stefanluethi/robby/doc/bench/results-2026-10-26.md

# Trace link benchmark, 2026-10-26

Hardware campaign of [the plan](../plan/protobuf-tracing.md) §7: the sonde firmware
(baseline) and the protobuf firmware (nanopb on the STM32, robby outpost on the ESP32),
measured on robby with the tools in `tools/bench`.

## Summary

- **The protobuf link carries all IMU samples with room to spare.** All 806 samples/s
  arrive with no gaps, against 403/s (decimated) with sonde. It uses **8 % of the UART**
  instead of 69 %, because each sample costs **~7 B on the UART instead of 159 B**
  (10 B/sample when the other traces are counted in).
- **sonde can't carry all samples.** With decimation off it fills the 1 Mbaud link
  (83 kB/s), delivers only 521 of 806 samples/s with 176 gaps (up to 141 ms) in 60 s,
  and the distance, battery and task traces stop entirely.
- **The ESP32 is now the bottleneck, not the UART.** The whole chain carries
  **~5.8k samples/s cleanly (~440 kB/s on WiFi)** and saturates at **~7k samples/s
  (~530 kB/s)**: the ESP32 CPU is at 96 % (idle 3.6 %) and its queue starts dropping.
  At that point the UART is only at 60 %; it would saturate at ~11–12k samples/s
  (85 % load, then the STM32 drops records).
- **The plain WiFi limit of the ESP32-C6** (outpost generating the data itself, no UART):
  clean up to **8k samples/s / 607 kB/s**, first drops at 9k / 683 kB/s, peak ~700 kB/s
  (≈ 5.6 Mbit/s), at RSSI −61 to −64 dBm.
- **Headroom:** the robot's stream today (806 samples/s) uses ~1/7 of the chain's clean
  capacity. Compared with sonde's maximum (521 samples/s), the chain carries **~11× more
  samples**.

| | sonde (H0-a) | sonde, all samples (H0-b) | protobuf (H1-a) |
|---|---:|---:|---:|
| IMU samples/s delivered | 402.6 (decimated by 2) | 521.3 of 806 | **806.7** |
| IMU gaps | 1 in 120 s | 176 in 60 s (22 s total, max 141 ms) | **0 in 120 s** |
| IMU interval jitter (stddev) | 0.11 ms | 9.4 ms | **0.05 ms** |
| UART load | 69.0 kB/s (69 %) | 83.0 kB/s (full) | **8.2 kB/s (8 %)** |
| UART bytes per IMU sample | 159 | 159 | **~7 (IMU only), 10.1 (incl. all traces)** |
| WiFi (WebSocket) | 69.0 kB/s | 83.0 kB/s | 61.2 kB/s (68 B/sample) |
| ToF / battery / tasks | 6.2 / 1 / 1 Hz | stopped | 6.2 / 1 / 1 Hz |
| STM32 `data_publisher` CPU | 8.4 % | – | 8.9 % |
| ESP32 CPU idle | – | – | 82 % |
| errors / drops | 0 | 0 counted, 35 % of samples lost | 0 |

## Where the limit is (H1-b, 1 Mbaud, ramp with `bench/load`)

Synthetic IMU-like samples on top of the normal stream (806 samples/s), 20 s per step.

| requested /s | delivered /s | ratio | WiFi kB/s | UART load | ESP32 idle | ESP32 queue drops | ESP32 UART errors | STM32 drops | max WS send |
|---:|---:|---:|---:|---:|---:|---:|---:|---:|---:|
| 1,000 | 1,000 | 100 % | 137 | 15 % | 68 % | 0 | 0 | 0 | 0.7 ms |
| 2,000 | 1,998 | 100 % | 213 | 24 % | 54 % | 0 | 0 | 0 | 0.4 ms |
| 3,000 | 3,000 | 100 % | 289 | 30 % | 39 % | 0 | 1 | 0 | 4 ms |
| 5,000 | 4,987 | 99.7 % | 440 | 44 % | 15 % | 0 | 1 (4 seq gaps) | 0 | 23 ms |
| 7,000 | 6,249 | 89 % | 535 | 60 % | **4 %** | **155** | 6 | 0 | 24 ms |
| 9,000 | 6,128 | 68 % | 519 | 74 % | 10 % | 618 | 3 | 0 | 56 ms |
| 11,000 | 5,805 | 53 % | 497 | 85 % | 3 % | 935 | 1 | **115** | 25 ms |
| 13,000 | 5,723 | 44 % | 491 | 87 % | 6 % | 1,008 | 1 | 454 | 26 ms |

How to read it (plan §5): the ESP32 runs out of CPU at ~7k samples/s (6.2k synthetic +
0.8k IMU) and drops frames from its UART→WebSocket queue, while the UART still has 40 %
left. Above that, the WiFi throughput even goes down a little (535 → 491 kB/s): the CPU
spends more time on frames it then drops. The UART itself tops out at ~85 % load
(11k requested), where the STM32 starts dropping records.

### WiFi alone (H1-w, `bench-wifi`, no UART)

| requested /s | delivered /s | ratio | WiFi kB/s | dropped by the generator | max WS send |
|---:|---:|---:|---:|---:|---:|
| 1,000 | 998 | 100 % | 77 | 0 | 0.1 ms |
| 2,000 | 2,004 | 100 % | 153 | 0 | 0.1 ms |
| 5,000 | 4,996 | 100 % | 381 | 0 | 0.7 ms |
| 6,000 | 6,008 | 100 % | 458 | 0 | 3 ms |
| 7,000 | 7,002 | 100 % | 533 | 0 | 3 ms |
| 8,000 | 7,977 | 99.7 % | 607 | 0 | 12 ms |
| 9,000 | 8,981 | 99.8 % | 683 | 136 | 20 ms |
| 10,000 | 9,168 | 92 % | 698 | 8,270 | 28 ms |

The plain WiFi/TCP path of the ESP32-C6 (esp-radio + embassy-net, 16 KiB TCP buffer,
4 KiB WebSocket frames) peaks at ~700 kB/s. The chain stops ~25 % earlier (530 kB/s),
because the ESP32 also receives, checks and decodes the UART. Note: in `bench-wifi` mode
the generator itself uses the CPU, so its `cpu_idle` isn't comparable with the chain's.

## Problems found

1. **`bench/load` dropped 87 % of its batches at 1000 samples/s** (the first ramp
   stopped at its first step). The backlog was measured from a batch's first sample,
   not from its last. Fixed during the campaign in A4's `51ad8f9`, with a host test.
2. **WiFi stalls of 200–350 ms overflow the ESP32 queue even at moderate load.** In a
   3k-samples/s step the WebSocket send stalled several times for up to 350 ms, and
   59 frames were dropped from the 32-frame queue (the next run of the same step was
   clean). At normal load (H1-a) the longest send was 0.6 ms and nothing was dropped.
3. **Sporadic ESP32 UART RX errors under load.** 1–6 CRC errors / RX errors per 20 s
   step from 3k samples/s on, none at normal load. This fits RX FIFO overruns while the
   CPU is busy with WiFi (risk noted in plan §8).
4. **An action answer can get lost under overload.** At 13k samples/s the final
   `bench/load {rate: 0}` got "no answer from the STM32": the `ActionResult` travels in
   the same uplink queue that was dropping frames. The next request worked.

## Not measured

- **H1-c, baud sweep (2–4 Mbaud):** skipped. At 1 Mbaud the UART still has 40 % left
  when the ESP32 saturates, so a faster UART can't raise the limit.
- **H1-w close to the AP:** needs the robot moved; all runs were at its normal place
  (RSSI −58 to −64 dBm).
- Each ramp step ran once; WiFi stalls (problem 2) make single steps near the limit
  vary from run to run.

## Next steps (suggestions)

- To raise the limit, make the ESP32 cheaper per sample: profile the translation /
  CBOR encoding on the target, send fewer, larger WebSocket frames, and try turning off
  WiFi power saving (untested).
- Robustness: a larger or byte-based uplink queue against WiFi stalls (problem 2), UART
  RX by DMA (UHCI) on the ESP32 (problem 3), and send `ActionResult`s ahead of the
  traces (problem 4).

## Setup

| | |
|---|---|
| baseline firmware | tag `bench/baseline-sonde` (892f3f3), both chips; H0-b with `ACCELERATION_DECIMATION {1U}` (local, not committed) |
| protobuf firmware | STM32 `claude/nanopb-core-1fc850` @ b37cb7c (H1-a) and 51ad8f9 (ramps); ESP32 `claude/protobuf-outpost-0ee3ad` @ 7eca843 (`--features bench-wifi` for H1-w) |
| link | USART2 ↔ UART1, 1 Mbaud 8N1 |
| WiFi | bridge at 192.168.1.70, RSSI −58 to −64 dBm, robot at its normal place |
| tools | `tools/bench` from `claude/bench-tooling-8ac75a` @ f4b4202; recordings in that worktree's `tools/bench/runs/` (not committed) |

The robot was left running the protobuf firmware (STM32 51ad8f9, ESP32 7eca843 without
`bench-wifi`).

## Appendix: generated tables

### Runs

| run | kind | label | started | duration s | notes |
| --- | --- | --- | --- | --- | --- |
| h0-a | capture | H0-a baseline sonde | 2026-10-26T21:28:47+01:00 | 120.0 | firmware=bench/baseline-sonde, baud=1000000, decimation=2 |
| h0-b | capture | H0-b sonde all samples | 2026-10-26T21:31:53+01:00 | 60.0 | firmware=bench/baseline-sonde+decimation1, baud=1000000, decimation=1 |
| h1-a | capture | H1-a protobuf | 2026-10-26T21:47:39+01:00 | 120.0 | firmware=nanopb-core@b37cb7c+outpost@7eca843, baud=1000000 |
| h1-b-full | ramp | H1-b full curve 1M | 2026-10-26T21:56:24+01:00 |  | baud=1000000, rssi=-62 |
| h1-w-near | ramp | H1-w WiFi only (robby position) | 2026-10-26T21:51:13+01:00 |  | firmware=outpost@7eca843+bench-wifi, rssi=-61, position=robby-normal |
| h1-w-fine | ramp | H1-w WiFi only, fine | 2026-10-26T21:52:14+01:00 |  | firmware=outpost@7eca843+bench-wifi, rssi=-61 |

### Comparison

Baseline: **h0-a**, ratios relative to it. `imu/acc` styles: h0-a per-axis, h0-b per-axis, h1-a record. UART bytes from: h0-a: WS, h0-b: WS, h1-a: counter (WS = WebSocket payload, the baseline bridge forwards UART frames 1:1).

| metric | h0-a | h0-b | h1-a |
| --- | ---: | ---: | ---: |
| WS payload kB/s | 69.0 | 83.0 (1.20×) | 61.2 (0.89×) |
| WS frames/s | 73 | 83 (1.14×) | 22 (0.29×) |
| messages/s | 1,241 | 1,565 (1.26×) | 861 (0.69×) |
| `imu/acc` samples/s | 402.6 | 521.3 (1.29×) | 806.7 (2.00×) |
| `imu/acc` WS bytes/sample | 159.0 | 159.0 (1.00×) | 68.0 (0.43×) |
| `imu/acc` interval mean ms | 2.481 | 1.920 (0.77×) | 1.240 (0.50×) |
| `imu/acc` interval stddev ms | 0.110 | 9.440 (86.04×) | 0.047 (0.43×) |
| `imu/acc` interval max ms | 15.510 | 141.152 (9.10×) | 1.380 (0.09×) |
| `imu/acc` gaps | 1 | 176 (176.00×) | 0 (0.00×) |
| UART kB/s | 69.0 | 83.0 (1.20×) | 8.2 (0.12×) |
| UART bytes/`imu/acc` sample | 171.4 | 159.2 (0.93×) | 10.1 (0.06×) |
| drops (counters) | 0 | 0 | 0 |
| decode errors | 0 | 0 | 0 |

### h0-a: traces

| path | msgs/s | B/msg | bytes | mean ms | stddev ms | max ms | gaps |
| --- | ---: | ---: | ---: | ---: | ---: | ---: | ---: |
| `imu/acc/x` | 402.6 | 53.0 | 30.9% | 2.481 | 0.110 | 15.510 | 1 |
| `imu/acc/z` | 402.6 | 53.0 | 30.9% | 2.481 | 0.117 | 18.110 | 1 |
| `imu/acc/y` | 402.6 | 53.0 | 30.9% | 2.481 | 0.117 | 18.110 | 1 |
| `tof/distance` | 6.2 | 492.4 | 4.4% | 161.949 | 48.472 | 338.000 | 0 |
| `tasks/data_publisher` | 0.9 | 114.0 | 0.2% | 1,056.491 | 46.869 | 1,122.000 | 0 |
| `tasks/acquisition` | 0.9 | 111.0 | 0.2% | 1,056.393 | 53.184 | 1,122.000 | 0 |
| `tasks/heartbeat` | 0.9 | 108.0 | 0.1% | 1,056.393 | 53.159 | 1,122.000 | 0 |
| `tasks/Tmr Svc` | 0.9 | 107.0 | 0.1% | 1,056.393 | 52.380 | 1,121.000 | 0 |
| `tasks/command` | 0.9 | 107.0 | 0.1% | 1,056.393 | 52.959 | 1,122.000 | 0 |
| `tasks/IDLE` | 0.9 | 103.0 | 0.1% | 1,056.491 | 46.860 | 1,122.000 | 0 |
| `tasks/imu` | 0.9 | 103.0 | 0.1% | 1,056.393 | 52.409 | 1,121.000 | 0 |
| `battery/voltage` | 1.0 | 59.0 | 0.1% | 1,007.771 | 43.472 | 1,119.000 | 0 |

4 more paths.

### h0-b: traces

| path | msgs/s | B/msg | bytes | mean ms | stddev ms | max ms | gaps |
| --- | ---: | ---: | ---: | ---: | ---: | ---: | ---: |
| `imu/acc/z` | 521.4 | 53.0 | 33.3% | 1.919 | 9.440 | 141.152 | 176 |
| `imu/acc/x` | 521.3 | 53.0 | 33.3% | 1.920 | 9.440 | 141.152 | 176 |
| `imu/acc/y` | 521.3 | 53.0 | 33.3% | 1.920 | 9.440 | 141.152 | 176 |

### h1-a: traces

| path | msgs/s | B/msg | bytes | mean ms | stddev ms | max ms | gaps |
| --- | ---: | ---: | ---: | ---: | ---: | ---: | ---: |
| `imu/acc` | 806.7 | 68.0 | 89.6% | 1.240 | 0.047 | 1.380 | 0 |
| `tof/distance` | 6.2 | 491.7 | 5.0% | 161.134 | 6.207 | 180.000 | 0 |
| `tasks/data_publisher` | 1.0 | 114.0 | 0.2% | 1,006.644 | 2.093 | 1,012.000 | 0 |
| `tasks/acquisition` | 1.0 | 110.9 | 0.2% | 1,006.644 | 2.093 | 1,012.000 | 0 |
| `tasks/heartbeat` | 1.0 | 107.0 | 0.2% | 1,006.644 | 2.093 | 1,012.000 | 0 |
| `tasks/Tmr Svc` | 1.0 | 107.0 | 0.2% | 1,006.644 | 2.093 | 1,012.000 | 0 |
| `tasks/command` | 1.0 | 105.0 | 0.2% | 1,006.644 | 2.093 | 1,012.000 | 0 |
| `tasks/IDLE` | 1.0 | 103.9 | 0.2% | 1,006.644 | 2.093 | 1,012.000 | 0 |
| `tasks/imu` | 1.0 | 102.9 | 0.2% | 1,006.644 | 2.093 | 1,012.000 | 0 |
| `outpost/queue_high_water` | 1.0 | 65.0 | 0.1% | 999.944 | 6.189 | 1,018.609 | 0 |
| `outpost/uart_rx_bytes` | 1.0 | 65.0 | 0.1% | 999.944 | 6.189 | 1,018.609 | 0 |
| `outpost/ws_tx_bytes` | 1.0 | 63.0 | 0.1% | 999.944 | 6.189 | 1,018.609 | 0 |

32 more paths.

| counter | last | delta | per s |
| --- | ---: | ---: | ---: |
| `link/baud` | 1e+06 | 0 | 0.0 |
| `link/records_dropped` (drop) | 0 | 0 | 0.0 |
| `link/rx_errors` (drop) | 0 | 0 | 0.0 |
| `link/rx_frames` | 0 | 0 | 0.0 |
| `link/rx_seq_gaps` (drop) | 0 | 0 | 0.0 |
| `link/tx_bytes` | 1.19825e+06 | 968273 | 8,151.5 |
| `link/tx_frame_rate` | 14.9105 | 990.401 | 8.3 |
| `link/tx_frames` | 2302 | 1880 | 15.8 |
| `link/tx_frames_dropped` (drop) | 0 | 0 | 0.0 |
| `link/tx_load` | 7.99801 | 594.907 | 5.0 |
| `link/tx_rate` | 7998.01 | 594907 | 5,008.3 |
| `link/tx_write_max` | 9883 | 478208 | 4,025.9 |
| `link/tx_write_time` | 1.00388 | 51.4297 | 0.4 |
| `outpost/bench_drops` (drop) | 0 | 0 | 0.0 |
| `outpost/cobs_errors` (drop) | 0 | 0 | 0.0 |
| `outpost/cpu_idle` | 81.5836 | 4780.49 | 40.5 |
| `outpost/crc_errors` (drop) | 0 | 0 | 0.0 |
| `outpost/decode_errors` (drop) | 0 | 0 | 0.0 |
| `outpost/queue_drops` (drop) | 0 | 0 | 0.0 |
| `outpost/queue_high_water` | 2 | 0 | 0.0 |
| `outpost/rssi` | -60 | -1565 | -13.3 |
| `outpost/seq_gaps` (drop) | 0 | 0 | 0.0 |
| `outpost/stm32_resets` | 0 | 0 | 0.0 |
| `outpost/uart_frames` | 2291 | 1869 | 15.8 |
| `outpost/uart_rx_bytes` | 1.19328e+06 | 963064 | 8,162.0 |
| `outpost/uart_rx_errors` (drop) | 0 | 0 | 0.0 |
| `outpost/ws_frames` | 2677 | 2546 | 21.6 |
| `outpost/ws_messages` | 106822 | 101597 | 861.0 |
| `outpost/ws_send_max` | 105 | 14599 | 123.7 |
| `outpost/ws_tx_bytes` | 7.59205e+06 | 7.22252e+06 | 61,211.2 |

### h1-b-full: ramp

knee between **11,000** and **13,000** samples/s (load trace `bench/synthetic`, 20 s per step, min ratio 50%).

Error: reset: bench/load {'rate': 0} rejected: no answer from the STM32

| requested /s | delivered /s | ratio | WS kB/s | drops | result |
| ---: | ---: | ---: | ---: | ---: | --- |
| 1,000 | 1,000 | 100.0% | 137.3 | 0 | ok |
| 2,000 | 1,998 | 99.9% | 212.9 | 0 | ok |
| 3,000 | 3,000 | 100.0% | 289.3 | 0 | ok |
| 5,000 | 4,987 | 99.7% | 439.6 | 0 | ok |
| 7,000 | 6,249 | 89.3% | 534.6 | 0 | ok |
| 9,000 | 6,128 | 68.1% | 519.0 | 0 | ok |
| 11,000 | 5,805 | 52.8% | 497.4 | 0 | ok |
| 13,000 | 5,723 | 44.0% | 490.6 | 0 | delivered 44.0% of the requested rate |

### h1-w-near: ramp

knee between **5,000** and **10,000** samples/s (load trace `bench/synthetic`, 10 s per step, min ratio 95%).

| requested /s | delivered /s | ratio | WS kB/s | drops | result |
| ---: | ---: | ---: | ---: | ---: | --- |
| 1,000 | 998 | 99.8% | 76.8 | 0 | ok |
| 2,000 | 2,004 | 100.2% | 153.2 | 0 | ok |
| 5,000 | 4,996 | 99.9% | 380.6 | 0 | ok |
| 10,000 | 9,168 | 91.7% | 697.5 | 8270 | drops (outpost/bench_drops +8270); delivered 91.7% of the requested rate |

### h1-w-fine: ramp

knee between **8,000** and **9,000** samples/s (load trace `bench/synthetic`, 15 s per step, min ratio 95%).

| requested /s | delivered /s | ratio | WS kB/s | drops | result |
| ---: | ---: | ---: | ---: | ---: | --- |
| 6,000 | 6,008 | 100.1% | 457.5 | 0 | ok |
| 7,000 | 7,002 | 100.0% | 532.9 | 0 | ok |
| 8,000 | 7,977 | 99.7% | 607.0 | 0 | ok |
| 9,000 | 8,981 | 99.8% | 683.3 | 136 | drops (outpost/bench_drops +136) |
