stefanluethi/robby/(list of files, drawings)

Other design files:
hardware/battery_pack/BatteryPack.PrjPcb
hardware/battery_pack/Charger.SchDoc
hardware/battery_pack/MonitoringProtection.SchDoc
hardware/battery_pack/Top.SchDoc
hardware/distance_sensor/DistanceSensor.PcbDoc
hardware/distance_sensor/DistanceSensor.PrjPcb
hardware/distance_sensor/DistanceSensor.SchDoc
hardware/motor_base/Connectivity.SchDoc
hardware/motor_base/DiscoCarrier.SchDoc
hardware/motor_base/Misc.SchDoc
hardware/motor_base/MotorBase.PrjPcb
hardware/motor_base/MotorDriver.SchDoc
hardware/motor_base/Power.SchDoc
hardware/motor_base/Top.SchDoc
hardware/panel/RobbyPanel.PcbDoc
hardware/panel/RobbyPanel.PrjPcb
hardware/sensor_addon/SensorAddOn.PcbDoc
hardware/sensor_addon/SensorAddOn.PrjPcb
hardware/sensor_addon/SensorAddOn.SchDoc
