stefanluethi/robby/app_core/Core/Src/main.c

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
/* Includes ------------------------------------------------------------------*/
#include "main.h"

/* USER CODE BEGIN Includes */
#include "driver/fuelgauge.h"
#include "glue/araldite.h"
#include "stm32f723e_disco_bus.h"
#include "stm32f723e_discovery_lcd.h"
#include "stm32f7xx_hal_def.h"
#include "stm32f7xx_hal_uart.h"
#include "stm32f7xx_it.h"

#include <FreeRTOS.h>
#include <task.h>

#include <stdint.h>
/* USER CODE END Includes */

ADC_HandleTypeDef hadc1;
ADC_HandleTypeDef hadc2;
ADC_HandleTypeDef hadc3;

I2C_HandleTypeDef hi2c1;
I2C_HandleTypeDef hi2c3;

QSPI_HandleTypeDef hqspi;

SAI_HandleTypeDef hsai_BlockA2;
SAI_HandleTypeDef hsai_BlockB2;

SPI_HandleTypeDef hspi2;

TIM_HandleTypeDef htim2;
TIM_HandleTypeDef htim3;
TIM_HandleTypeDef htim5;
TIM_HandleTypeDef htim8;
TIM_HandleTypeDef htim9;
TIM_HandleTypeDef htim12;

UART_HandleTypeDef huart4;
UART_HandleTypeDef huart5;
UART_HandleTypeDef huart7;
UART_HandleTypeDef huart2;
UART_HandleTypeDef huart6;
DMA_HandleTypeDef hdma_usart2_rx;
DMA_HandleTypeDef hdma_usart6_rx;

HCD_HandleTypeDef hhcd_USB_OTG_FS;
HCD_HandleTypeDef hhcd_USB_OTG_HS;

SRAM_HandleTypeDef hsram1;
SRAM_HandleTypeDef hsram2;

void SystemClock_Config(void);
void PeriphCommonClock_Config(void);
static void MX_GPIO_Init(void);
static void MX_DMA_Init(void);
static void MX_ADC1_Init(void);
static void MX_ADC2_Init(void);
static void MX_ADC3_Init(void);
static void MX_FMC_Init(void);
static void MX_I2C3_Init(void);
static void MX_QUADSPI_Init(void);
static void MX_SAI2_Init(void);
static void MX_SPI2_Init(void);
static void MX_TIM2_Init(void);
static void MX_TIM3_Init(void);
static void MX_TIM5_Init(void);
static void MX_TIM9_Init(void);
static void MX_TIM12_Init(void);
static void MX_UART4_Init(void);
static void MX_UART5_Init(void);
static void MX_UART7_Init(void);
static void MX_USART2_UART_Init(void);
static void MX_USB_OTG_FS_HCD_Init(void);
static void MX_USB_OTG_HS_HCD_Init(void);
static void MX_TIM8_Init(void);
static void MX_I2C1_Init(void);
static void MX_USART6_UART_Init(void);
/**
  * @brief  The application entry point.
  * @retval int
  */
int main(void)
{

  /* MCU Configuration--------------------------------------------------------*/

  /* Reset of all peripherals, Initializes the Flash interface and the Systick. */
  HAL_Init();

  /* Configure the system clock */
  SystemClock_Config();

  /* Configure the peripherals common clocks */
  PeriphCommonClock_Config();

  /* Initialize all configured peripherals */
  MX_GPIO_Init();
  MX_DMA_Init();
  MX_ADC1_Init();
  MX_ADC2_Init();
  MX_ADC3_Init();
  MX_FMC_Init();
  MX_I2C3_Init();
  MX_QUADSPI_Init();
  MX_SAI2_Init();
  MX_SPI2_Init();
  MX_TIM2_Init();
  MX_TIM3_Init();
  MX_TIM5_Init();
  MX_TIM9_Init();
  MX_TIM12_Init();
  MX_UART4_Init();
  MX_UART5_Init();
  MX_UART7_Init();
  MX_USART2_UART_Init();
  MX_USB_OTG_FS_HCD_Init();
  MX_USB_OTG_HS_HCD_Init();
  MX_TIM8_Init();
  MX_I2C1_Init();
  MX_USART6_UART_Init();
  /* USER CODE BEGIN 2 */
    BSP_LCD_InitEx(LCD_ORIENTATION_LANDSCAPE_ROT180);
    BSP_LCD_Clear(LCD_COLOR_BLACK);

    // BSP_I2C2_Init();
    // volatile bool res = fuelgauge_init();

    // uint8_t soc = 0U;
    // res = fuelgauge_get_soc(&soc);
    HAL_TIM_PWM_Start(&htim9, TIM_CHANNEL_1);
    HAL_TIM_PWM_Start(&htim9, TIM_CHANNEL_2);
    CommandHandler_Start_RX_DMA();
    RESIN_launch_app();

  /* USER CODE END 2 */

  /* Infinite loop */
  /* USER CODE BEGIN WHILE */
    while (1) {
    /* USER CODE END WHILE */

    /* USER CODE BEGIN 3 */
    }
  /* USER CODE END 3 */
}

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
/* USER CODE BEGIN 4 */
int __io_putchar(int ch) {
    /* Place your implementation of fputc here */
    /* e.g. write a character to the USART1 and Loop until the end of
     * transmission */
    // HAL_UART_Transmit(&huart6, (uint8_t *)&ch, 1, 0xFFFF);

    return ch;
}

void vConfigureTimerForRunTimeStats(void) {
    /* Enable DWT */
    CoreDebug->DEMCR |= CoreDebug_DEMCR_TRCENA_Msk;

    /* Reset and enable cycle counter */
    DWT->CYCCNT = 0UL;
    DWT->CTRL |= DWT_CTRL_CYCCNTENA_Msk;
}

extern uint32_t getRuntimeCount(void)
{
    // return DWT->CYCCNT;
    return HAL_GetTick();
}

void vApplicationMallocFailedHook(void)
{
    while (true);
}

void vApplicationStackOverflowHook(TaskHandle_t task, char *taskName)
{
    printf("!!! Stack overflow in task %s !!!\n", taskName);
    vTaskDelete(task);
}

/* USER CODE END 4 */

/**
  * @brief  Period elapsed callback in non blocking mode
  * @note   This function is called  when TIM1 interrupt took place, inside
  * HAL_TIM_IRQHandler(). It makes a direct call to HAL_IncTick() to increment
  * a global variable "uwTick" used as application time base.
  * @param  htim : TIM handle
  * @retval None
  */
void HAL_TIM_PeriodElapsedCallback(TIM_HandleTypeDef *htim)
{
  if (htim->Instance == TIM1)
  {
    HAL_IncTick();
  }
}

/**
  * @brief  This function is executed in case of error occurrence.
  * @retval None
  */
void Error_Handler(void)
{
  /* USER CODE BEGIN Error_Handler_Debug */
    /* User can add his own implementation to report the HAL error return state
     */
    __disable_irq();
    while (1) {
    }
  /* USER CODE END Error_Handler_Debug */
}
#ifdef USE_FULL_ASSERT
/**
  * @brief  Reports the name of the source file and the source line number
  *         where the assert_param error has occurred.
  * @param  file: pointer to the source file name
  * @param  line: assert_param error line source number
  * @retval None
  */
void assert_failed(uint8_t *file, uint32_t line)
{
  /* USER CODE BEGIN 6 */
    /* User can add his own implementation to report the file name and line
       number, ex: printf("Wrong parameters value: file %s on line %d\r\n",
       file, line) */
  /* USER CODE END 6 */
}
#endif /* USE_FULL_ASSERT */
