stefanluethi/robby/app_core/Core/Inc/main.h

#define MOT_EN_1_Pin GPIO_PIN_3
#define MOT_EN_1_GPIO_Port GPIOE
#define QSPI_D2_Pin GPIO_PIN_2
#define QSPI_D2_GPIO_Port GPIOE
#define PSRAM_NBL1_Pin GPIO_PIN_1
#define PSRAM_NBL1_GPIO_Port GPIOE
#define PSRAM_NBL0_Pin GPIO_PIN_0
#define PSRAM_NBL0_GPIO_Port GPIOE
#define SAI2_I2C1_SCL_Pin GPIO_PIN_8
#define SAI2_I2C1_SCL_GPIO_Port GPIOB
#define ARD_D11_Pin GPIO_PIN_5
#define ARD_D11_GPIO_Port GPIOB
#define WIFI_RST_Pin GPIO_PIN_14
#define WIFI_RST_GPIO_Port GPIOG
#define WIFI_GPIO_0_Pin GPIO_PIN_13
#define WIFI_GPIO_0_GPIO_Port GPIOG
#define ARD_D12_Pin GPIO_PIN_4
#define ARD_D12_GPIO_Port GPIOB
#define SYS_STLINK_JTDO_SWO_Pin GPIO_PIN_3
#define SYS_STLINK_JTDO_SWO_GPIO_Port GPIOB
#define PSRAM_NE1_Pin GPIO_PIN_7
#define PSRAM_NE1_GPIO_Port GPIOD
#define UART_TXD_WIFI_RX_Pin GPIO_PIN_12
#define UART_TXD_WIFI_RX_GPIO_Port GPIOC
#define TOF_SYNC3_Pin GPIO_PIN_15
#define TOF_SYNC3_GPIO_Port GPIOA
#define MOT_EN_2_Pin GPIO_PIN_4
#define MOT_EN_2_GPIO_Port GPIOE
#define MOT_PWM_1_Pin GPIO_PIN_5
#define MOT_PWM_1_GPIO_Port GPIOE
#define MOT_PWM_2_Pin GPIO_PIN_6
#define MOT_PWM_2_GPIO_Port GPIOE
#define SAI2_I2C1_SDA_Pin GPIO_PIN_9
#define SAI2_I2C1_SDA_GPIO_Port GPIOB
#define NC1_Pin GPIO_PIN_7
#define NC1_GPIO_Port GPIOB
#define QSPI_NCS_Pin GPIO_PIN_6
#define QSPI_NCS_GPIO_Port GPIOB
#define SAI2_INT_Pin GPIO_PIN_15
#define SAI2_INT_GPIO_Port GPIOG
#define SAI2_INT_EXTI_IRQn EXTI15_10_IRQn
#define PMOD_GPIO_0_Pin GPIO_PIN_12
#define PMOD_GPIO_0_GPIO_Port GPIOG
#define SAI2_SD_B_Pin GPIO_PIN_10
#define SAI2_SD_B_GPIO_Port GPIOG
#define WIFI_GPIO_2_Pin GPIO_PIN_6
#define WIFI_GPIO_2_GPIO_Port GPIOD
#define LCD_PSRAM_D2_Pin GPIO_PIN_0
#define LCD_PSRAM_D2_GPIO_Port GPIOD
#define TOF_INT_Pin GPIO_PIN_11
#define TOF_INT_GPIO_Port GPIOC
#define TOF_INT_EXTI_IRQn EXTI15_10_IRQn
#define QSPI_D1_Pin GPIO_PIN_10
#define QSPI_D1_GPIO_Port GPIOC
#define SAI2_FS_A_Pin GPIO_PIN_7
#define SAI2_FS_A_GPIO_Port GPIOI
#define SAI2_SD_A_Pin GPIO_PIN_6
#define SAI2_SD_A_GPIO_Port GPIOI
#define SAI2_SCK_A_Pin GPIO_PIN_5
#define SAI2_SCK_A_GPIO_Port GPIOI
#define LCD_NE_Pin GPIO_PIN_9
#define LCD_NE_GPIO_Port GPIOG
#define LCD_PSRAM_NWE_Pin GPIO_PIN_5
#define LCD_PSRAM_NWE_GPIO_Port GPIOD
#define LCD_PSRAM_D3_Pin GPIO_PIN_1
#define LCD_PSRAM_D3_GPIO_Port GPIOD
#define TOF_MOSI_Pin GPIO_PIN_3
#define TOF_MOSI_GPIO_Port GPIOI
#define TOF_MISO_Pin GPIO_PIN_2
#define TOF_MISO_GPIO_Port GPIOI
#define CTP_INT_Pin GPIO_PIN_9
#define CTP_INT_GPIO_Port GPIOI
#define SAI2_MCLK_A_Pin GPIO_PIN_4
#define SAI2_MCLK_A_GPIO_Port GPIOI
#define LCD_PSRAM_NWED4_Pin GPIO_PIN_4
#define LCD_PSRAM_NWED4_GPIO_Port GPIOD
#define WIFI_CH_PD_Pin GPIO_PIN_3
#define WIFI_CH_PD_GPIO_Port GPIOD
#define UART_RXD_WIFI_TX_Pin GPIO_PIN_2
#define UART_RXD_WIFI_TX_GPIO_Port GPIOD
#define PMOD_SEL_0_Pin GPIO_PIN_15
#define PMOD_SEL_0_GPIO_Port GPIOH
#define TOF_SCK_Pin GPIO_PIN_1
#define TOF_SCK_GPIO_Port GPIOI
#define USB_OTG_FS_ID_Pin GPIO_PIN_10
#define USB_OTG_FS_ID_GPIO_Port GPIOA
#define PSRAM_A0_Pin GPIO_PIN_0
#define PSRAM_A0_GPIO_Port GPIOF
#define STMOD_UART4_TXD_Pin GPIO_PIN_13
#define STMOD_UART4_TXD_GPIO_Port GPIOH
#define STMOD_UART4_RXD_Pin GPIO_PIN_14
#define STMOD_UART4_RXD_GPIO_Port GPIOH
#define TOF_CS1_Pin GPIO_PIN_0
#define TOF_CS1_GPIO_Port GPIOI
#define PMOD_GPIO_1_Pin GPIO_PIN_2
#define PMOD_GPIO_1_GPIO_Port GPIOH
#define QSPI_D0_Pin GPIO_PIN_9
#define QSPI_D0_GPIO_Port GPIOC
#define CTP_SCL_Pin GPIO_PIN_8
#define CTP_SCL_GPIO_Port GPIOA
#define MOT_SLEEP_Pin GPIO_PIN_3
#define MOT_SLEEP_GPIO_Port GPIOH
#define LCD_TE_INT_Pin GPIO_PIN_8
#define LCD_TE_INT_GPIO_Port GPIOC
#define VCP_RX_Pin GPIO_PIN_7
#define VCP_RX_GPIO_Port GPIOC
#define PSRAM_A2_Pin GPIO_PIN_2
#define PSRAM_A2_GPIO_Port GPIOF
#define PSRAM_A1_Pin GPIO_PIN_1
#define PSRAM_A1_GPIO_Port GPIOF
#define ARD_D15_STMOD_I2C2_SCL_Pin GPIO_PIN_4
#define ARD_D15_STMOD_I2C2_SCL_GPIO_Port GPIOH
#define USB_OTGFS_PPWR_EN_Pin GPIO_PIN_8
#define USB_OTGFS_PPWR_EN_GPIO_Port GPIOG
#define VCP_TX_Pin GPIO_PIN_6
#define VCP_TX_GPIO_Port GPIOC
#define PSRAM_A3_Pin GPIO_PIN_3
#define PSRAM_A3_GPIO_Port GPIOF
#define PSRAM_A4_Pin GPIO_PIN_4
#define PSRAM_A4_GPIO_Port GPIOF
#define ARD_D14_STMOD_I2C2_SDA_Pin GPIO_PIN_5
#define ARD_D14_STMOD_I2C2_SDA_GPIO_Port GPIOH
#define PMOD_UART7_TXD_Pin GPIO_PIN_7
#define PMOD_UART7_TXD_GPIO_Port GPIOF
#define PMOD_UART7_RXD_Pin GPIO_PIN_6
#define PMOD_UART7_RXD_GPIO_Port GPIOF
#define PSRAM_A5_Pin GPIO_PIN_5
#define PSRAM_A5_GPIO_Port GPIOF
#define USB_OTGHS_PPWR_EN_Pin GPIO_PIN_12
#define USB_OTGHS_PPWR_EN_GPIO_Port GPIOH
#define PSRAM_A15_Pin GPIO_PIN_5
#define PSRAM_A15_GPIO_Port GPIOG
#define PSRAM_A14_Pin GPIO_PIN_4
#define PSRAM_A14_GPIO_Port GPIOG
#define PSRAM_A13_Pin GPIO_PIN_3
#define PSRAM_A13_GPIO_Port GPIOG
#define ARD_A3_ADC3_IN8_Pin GPIO_PIN_10
#define ARD_A3_ADC3_IN8_GPIO_Port GPIOF
#define PMOD_UART7_CTS_Pin GPIO_PIN_9
#define PMOD_UART7_CTS_GPIO_Port GPIOF
#define PMOD_UART7_RTS_Pin GPIO_PIN_8
#define PMOD_UART7_RTS_GPIO_Port GPIOF
#define LCD_BL_Pin GPIO_PIN_11
#define LCD_BL_GPIO_Port GPIOH
#define USB_OTGHS_OVCR_INT_Pin GPIO_PIN_10
#define USB_OTGHS_OVCR_INT_GPIO_Port GPIOH
#define LCD_PSRAM_D1_Pin GPIO_PIN_15
#define LCD_PSRAM_D1_GPIO_Port GPIOD
#define PSRAM_A12_Pin GPIO_PIN_2
#define PSRAM_A12_GPIO_Port GPIOG
#define ARD_A4_Pin GPIO_PIN_0
#define ARD_A4_GPIO_Port GPIOC
#define ARD_A5_Pin GPIO_PIN_1
#define ARD_A5_GPIO_Port GPIOC
#define TOF_SYNC2_Pin GPIO_PIN_2
#define TOF_SYNC2_GPIO_Port GPIOC
#define TOF_SYNC1_Pin GPIO_PIN_3
#define TOF_SYNC1_GPIO_Port GPIOC
#define QSPI_CLK_Pin GPIO_PIN_2
#define QSPI_CLK_GPIO_Port GPIOB
#define PSRAM_A11_Pin GPIO_PIN_1
#define PSRAM_A11_GPIO_Port GPIOG
#define ARD_D9_TIM12_CH1_Pin GPIO_PIN_6
#define ARD_D9_TIM12_CH1_GPIO_Port GPIOH
#define CTP_SDA_Pin GPIO_PIN_8
#define CTP_SDA_GPIO_Port GPIOH
#define CTP_RST_Pin GPIO_PIN_9
#define CTP_RST_GPIO_Port GPIOH
#define LCD_PSRAM_D0_Pin GPIO_PIN_14
#define LCD_PSRAM_D0_GPIO_Port GPIOD
#define QSPI_D3_Pin GPIO_PIN_13
#define QSPI_D3_GPIO_Port GPIOD
#define ARD_D10_TIM2_CH2_SPI1_NSS_Pin GPIO_PIN_1
#define ARD_D10_TIM2_CH2_SPI1_NSS_GPIO_Port GPIOA
#define SYS_B_User_Pin GPIO_PIN_0
#define SYS_B_User_GPIO_Port GPIOA
#define ARD_A1_Pin GPIO_PIN_4
#define ARD_A1_GPIO_Port GPIOA
#define ARD_A2_Pin GPIO_PIN_4
#define ARD_A2_GPIO_Port GPIOC
#define PSRAM_A7_Pin GPIO_PIN_13
#define PSRAM_A7_GPIO_Port GPIOF
#define PSRAM_A10_Pin GPIO_PIN_0
#define PSRAM_A10_GPIO_Port GPIOG
#define LCD_PSRAM_D10_Pin GPIO_PIN_13
#define LCD_PSRAM_D10_GPIO_Port GPIOE
#define LCD_RST_Pin GPIO_PIN_7
#define LCD_RST_GPIO_Port GPIOH
#define PSRAM_A17_Pin GPIO_PIN_12
#define PSRAM_A17_GPIO_Port GPIOD
#define PSRAM_A16_Pin GPIO_PIN_11
#define PSRAM_A16_GPIO_Port GPIOD
#define LCD_PSRAM_D15_Pin GPIO_PIN_10
#define LCD_PSRAM_D15_GPIO_Port GPIOD
#define ARD_D1_USART2_TX_Pin GPIO_PIN_2
#define ARD_D1_USART2_TX_GPIO_Port GPIOA
#define ARD_A0_Pin GPIO_PIN_6
#define ARD_A0_GPIO_Port GPIOA
#define ARD_D13_TIM2_CH1_Pin GPIO_PIN_5
#define ARD_D13_TIM2_CH1_GPIO_Port GPIOA
#define ARD_D2_GPIO_Pin GPIO_PIN_5
#define ARD_D2_GPIO_GPIO_Port GPIOC
#define PSRAM_A6_Pin GPIO_PIN_12
#define PSRAM_A6_GPIO_Port GPIOF
#define PSRAM_A9_Pin GPIO_PIN_15
#define PSRAM_A9_GPIO_Port GPIOF
#define LCD_PSRAM_D5_Pin GPIO_PIN_8
#define LCD_PSRAM_D5_GPIO_Port GPIOE
#define LCD_PSRAM_D6_Pin GPIO_PIN_9
#define LCD_PSRAM_D6_GPIO_Port GPIOE
#define LCD_PSRAM_D8_Pin GPIO_PIN_11
#define LCD_PSRAM_D8_GPIO_Port GPIOE
#define LCD_PSRAM_D11_Pin GPIO_PIN_14
#define LCD_PSRAM_D11_GPIO_Port GPIOE
#define USB_OTG_HS_ID_Pin GPIO_PIN_12
#define USB_OTG_HS_ID_GPIO_Port GPIOB
#define USB_OTG_HS_VBUS_Pin GPIO_PIN_13
#define USB_OTG_HS_VBUS_GPIO_Port GPIOB
#define USB_OTG_HS_VBUS_EXTI_IRQn EXTI15_10_IRQn
#define LCD_PSRAM_D14_Pin GPIO_PIN_9
#define LCD_PSRAM_D14_GPIO_Port GPIOD
#define LCD_PSRAM_D13_Pin GPIO_PIN_8
#define LCD_PSRAM_D13_GPIO_Port GPIOD
#define ARD_D0_USART2_RX_Pin GPIO_PIN_3
#define ARD_D0_USART2_RX_GPIO_Port GPIOA
#define SYS_LD_USER1_Pin GPIO_PIN_7
#define SYS_LD_USER1_GPIO_Port GPIOA
#define SYS_LD_USER2_Pin GPIO_PIN_1
#define SYS_LD_USER2_GPIO_Port GPIOB
#define TOF_CS3_Pin GPIO_PIN_11
#define TOF_CS3_GPIO_Port GPIOF
#define PSRAM_A8_Pin GPIO_PIN_14
#define PSRAM_A8_GPIO_Port GPIOF
#define LCD_PSRAM_D4_Pin GPIO_PIN_7
#define LCD_PSRAM_D4_GPIO_Port GPIOE
#define LCD_PSRAM_D7_Pin GPIO_PIN_10
#define LCD_PSRAM_D7_GPIO_Port GPIOE
#define LCD_PSRAM_D9_Pin GPIO_PIN_12
#define LCD_PSRAM_D9_GPIO_Port GPIOE
#define LCD_PSRAM_D12_Pin GPIO_PIN_15
#define LCD_PSRAM_D12_GPIO_Port GPIOE
#define USB_OTGFS_OVCR_INT_Pin GPIO_PIN_10
#define USB_OTGFS_OVCR_INT_GPIO_Port GPIOB
#define USB_OTGFS_OVCR_INT_EXTI_IRQn EXTI15_10_IRQn
#define TOF_CS2_Pin GPIO_PIN_11
#define TOF_CS2_GPIO_Port GPIOB
