stefanluethi/robby/app_web/control-center/src/app.rs

mod proto_parser;
mod view;
mod model;

use std::collections::BTreeMap;
use eframe::Frame;
use egui::Context;
use view::Viewable;

#[derive(serde::Deserialize, serde::Serialize)]
#[serde(default)] // if we add new fields, give them default values when deserializing old state
pub struct State {
    stream_view: view::plot::Plot,
    task_manager: view::task_manager::TaskManager,
    room_view: view::heatmap::Heatmap,

    model: model::Model,

    target_address: String,

    #[serde(skip)]
    ws_receiver: Option<ewebsock::WsReceiver>,
    #[serde(skip)]
    ws_sender: Option<ewebsock::WsSender>,

    #[serde(skip)]
    panes_in_tabs: std::collections::HashSet<egui_tiles::TileId>,
}

impl Default for State {
    fn default() -> Self {
        Self {
            target_address: "ws://192.168.1.70/ws/robby".to_owned(),
            stream_view: view::plot::Plot::new(),
            task_manager: view::task_manager::TaskManager::new(),
            room_view: view::heatmap::Heatmap::new(),
            model: model::Model::default(),
            ws_receiver: None,
            ws_sender: None,
            panes_in_tabs: std::collections::HashSet::new(),
        }
    }
}

impl State {
    fn websocket_connect(&mut self, ctx: egui::Context) {
        let wakeup = move || ctx.request_repaint();
        let mut options = ewebsock::Options::default();
        options.max_incoming_frame_size = 2048;
        let (sender, receiver) =
            ewebsock::connect_with_wakeup(self.target_address.clone(), options, wakeup).unwrap();
        self.ws_receiver = Some(receiver);
        self.ws_sender = Some(sender);
    }

    fn websocket_disconnect(&mut self) {
        if let Some(sender) = self.ws_sender.as_mut() {
            sender.close();
        }
        self.ws_receiver = None;
        self.ws_sender = None;
        log::info!("ws disconnected")
    }

    fn websocket_receive(&mut self) -> bool {
        if let Some(receiver) = self.ws_receiver.as_ref() {
            while let Some(event) = receiver.try_recv() {
                match event {
                    ewebsock::WsEvent::Opened => {
                        log::info!("ws connected");
                    }
                    ewebsock::WsEvent::Message(message) => match message {
                        ewebsock::WsMessage::Text(msg) => {
                            log::info!("{}", msg);
                        }
                        ewebsock::WsMessage::Binary(msg) => {
                            proto_parser::parse_message(msg, &mut self.model);
                        }
                        _ => {
                            log::warn!("ws unknown message received");
                        }
                    },
                    ewebsock::WsEvent::Error(e) => {
                        log::warn!("ws error: {}", e);
                        return true;
                    }
                    ewebsock::WsEvent::Closed => {
                        log::info!("ws disconnected");
                        return true;
                    }
                };
            }
        }
        false
    }

    fn websocket_send(&mut self, command: proto::Action) {
        if let Some(sender) = self.ws_sender.as_mut() {
            let command_packet = serde_cbor_2::to_vec(&command).unwrap();
            log::debug!("send command {}", hex_string::HexString::from_bytes(&command_packet).as_string());
            sender.send(ewebsock::WsMessage::Binary(command_packet));
        }
    }

    fn settings_ui(&mut self, ui: &mut egui::Ui) {
        ui.heading("robby control center");

        ui.horizontal(|ui| {
            ui.label("websocket address:");
            ui.text_edit_singleline(&mut self.target_address);
            if ui
                .button(if self.ws_receiver.is_none() {
                    "Connect"
                } else {
                    "Disconnect"
                })
                .clicked()
            {
                if self.ws_receiver.is_none() {
                    self.websocket_connect(ui.ctx().clone());
                } else {
                    self.websocket_disconnect();
                }
            }
        });
    }
}



//--------------------------------------------------------------------------------------------------

#[derive(serde::Deserialize, serde::Serialize)]
enum Pane {
    Plots,
    AppLogs,
    TargetLogs,
    TaskManager,
    RoomView,
}

impl From<&Pane> for &str {
    fn from(value: &Pane) -> Self {
        match value {
            Pane::Plots => "Data Streams",
            Pane::AppLogs => "App Logs",
            Pane::TargetLogs => "Target Logs",
            Pane::TaskManager => "Task Manager",
            Pane::RoomView => "Room View",
        }
    }
}

impl From<&mut Pane> for &str {
    fn from(value: &mut Pane) -> Self {
        (value as &Pane).into()
    }
}

impl egui_tiles::Behavior<Pane> for State {
    fn pane_ui(
        &mut self,
        ui: &mut egui::Ui,
        _tile_id: egui_tiles::TileId,
        pane: &mut Pane,
    ) -> egui_tiles::UiResponse {
        let title: &str = pane.into();
        let mut drag_response = egui_tiles::UiResponse::None;

        let is_tab = self.panes_in_tabs.contains(&_tile_id);

        if !is_tab {
            let title_bar_color = if ui.visuals().dark_mode {
                ui.visuals().extreme_bg_color
            } else {
                ui.visuals().widgets.inactive.bg_fill
            };
            let title_bar_response = egui::Frame::NONE
                .fill(title_bar_color)
                .inner_margin(egui::Margin::symmetric(8, 3))
                .show(ui, |ui| {
                    ui.horizontal(|ui| {
                        ui.strong(title);
                        ui.allocate_space(ui.available_size())
                    })
                        .response
                })
                .inner;

            if title_bar_response
                .interact(egui::Sense::click_and_drag())
                .dragged()
            {
                drag_response = egui_tiles::UiResponse::DragStarted;
            }
        }

        egui::Frame::NONE
            .inner_margin(egui::Margin::same(10))
            .show(ui, |ui| {
                match pane {
                    Pane::Plots => {
                        self.stream_view.view(ui, &mut self.model);
                    }
                    Pane::AppLogs => {
                        egui_logger::logger_ui()
                            // .enable_category("robby_control_center::app", true)
                            // .enable_category("robby_control_center::app::proto_parser", true)
                            // .enable_category("robby_control_center::app::model::streams", true)
                            .include_target(false)
                            .show(ui);
                    }
                    Pane::TargetLogs => {
                        egui_logger::logger_ui()
                            // .enable_category("robby", true)
                            .include_target(false)
                            .show(ui);
                    }
                    Pane::TaskManager => {
                        self.task_manager.view(ui, &mut self.model);
                    }
                    Pane::RoomView => {
                        self.room_view.view(ui, &mut self.model);
                    }
                }
            });

        drag_response
    }

    fn tab_title_for_pane(&mut self, pane: &Pane) -> egui::WidgetText {
        Into::<&str>::into(pane).into()
    }
}

#[derive(serde::Deserialize, serde::Serialize)]
#[serde(default)] // if we add new fields, give them default values when deserializing old state
pub struct App {
    state: State,
    pane_tree: egui_tiles::Tree<Pane>,
}

impl Default for App {
    fn default() -> Self {
        Self {
            state: Default::default(),
            pane_tree: App::create_tree(),
        }
    }
}

impl App {
    fn create_tree() -> egui_tiles::Tree<Pane> {
        let mut tiles = egui_tiles::Tiles::default();
        let plots = tiles.insert_pane(Pane::Plots);
        let app_logs = tiles.insert_pane(Pane::AppLogs);
        let target_logs = tiles.insert_pane(Pane::TargetLogs);
        let task_manager = tiles.insert_pane(Pane::TaskManager);
        let room_view = tiles.insert_pane(Pane::RoomView);

        let view_n_task_manager = tiles.insert_horizontal_tile(vec![room_view, task_manager]);
        let plots_n_view = tiles.insert_vertical_tile(vec![plots, view_n_task_manager]);
        let logs = tiles.insert_tab_tile(vec![app_logs, target_logs]);
        let root = tiles.insert_horizontal_tile(vec![plots_n_view, logs]);

        egui_tiles::Tree::new("main_tree", root, tiles)
    }

    /// Called once before the first frame.
    pub fn new(cc: &eframe::CreationContext<'_>) -> Self {
        // This is also where you can customize the look and feel of egui using
        // `cc.egui_ctx.set_visuals` and `cc.egui_ctx.set_fonts`.

        configure_text_styles(&cc.egui_ctx);

        // Load previous app state (if any).
        // Note that you must enable the `persistence` feature for this to work.
        let mut app: Self = if let Some(storage) = cc.storage {
            eframe::get_value(storage, eframe::APP_KEY).unwrap_or_default()
        } else {
            Default::default()
        };

        if app.pane_tree.root.is_none() {
            app.pane_tree = App::create_tree();
        }

        // renew tree if new panes have been added
        // if !app.pane_tree.inactive_tiles().is_empty() {
        //    app.pane_tree = App::create_tree();
        // }

        app
    }
}

impl eframe::App for App {
    fn logic(&mut self, _ctx: &Context, _frame: &mut Frame) {
        if self.state.websocket_receive() {
            self.state.websocket_disconnect();
        }
    }
    fn ui(&mut self, ui: &mut egui::Ui, _frame: &mut eframe::Frame) {
        // todo: find viable solution!!!
        let old_value = self.state.task_manager.value();

        self.state.panes_in_tabs.clear();
        for (_, tile) in self.pane_tree.tiles.iter() {
            if let egui_tiles::Tile::Container(c) = tile {
                if c.kind() == egui_tiles::ContainerKind::Tabs {
                    for &child in c.children() {
                        self.state.panes_in_tabs.insert(child);
                    }
                }
            }
        }

        egui::Panel::top("top panel").show_inside(ui, |ui| {
            ui.with_layout(egui::Layout::top_down(egui::Align::LEFT), |ui| {
                self.state.settings_ui(ui);
            });
        });

        egui::Panel::bottom("bottom panel").show_inside(ui, |ui| {
            ui.with_layout(egui::Layout::bottom_up(egui::Align::LEFT), |ui| {
                egui::widgets::global_theme_preference_buttons(ui);
                egui::warn_if_debug_build(ui);
            });
        });

        egui::CentralPanel::default()
            .frame(egui::Frame::central_panel(ui.style()).inner_margin(egui::Margin::ZERO))
            .show_inside(ui, |ui| {
            self.pane_tree.ui(&mut self.state, ui);
        });

        let new_value = self.state.task_manager.value();
        if new_value != old_value {
            self.state.websocket_send(proto::Action::SetMotorSpeed((new_value * 10.0_f32) as u16));
        }

    }

    fn save(&mut self, storage: &mut dyn eframe::Storage) {
        eframe::set_value(storage, eframe::APP_KEY, self);
    }
}

fn configure_text_styles(ctx: &egui::Context) {
    use egui::FontFamily::{Monospace, Proportional};
    use egui::FontId;
    use egui::style::TextStyle;

    let text_styles: BTreeMap<TextStyle, FontId> = [
        (TextStyle::Heading, FontId::new(24.0, Proportional)),
        (TextStyle::Body, FontId::new(14.0, Proportional)),
        (TextStyle::Monospace, FontId::new(10.0, Monospace)),
        (TextStyle::Button, FontId::new(14.0, Proportional)),
        (TextStyle::Small, FontId::new(10.0, Proportional)),
    ]
    .into();
    ctx.all_styles_mut(move |style| style.text_styles = text_styles.clone());
}
