stefanluethi/robby/app_core/src/service/distance_visualizer.cpp

#include "distance_visualizer.h"

#include "main.h"
#include "rtos/Task.h"
#include "stm32f7xx_hal_gpio.h"
#include "stm32f7xx_hal_uart.h"
#include "util/colormap.h"

#include "service/imu.h"

#include <stm32f723e_discovery_lcd.h>
#include <stm32f7xx_hal.h>

#include <cstdio>

extern "C" {
#include <vl53l8cx_api.h>
}

#define CONF_POLLING_PERIOD (1U)
#define CONF_SENSOR_FREQUENCY_HZ (10U)
#define CONF_N_SENSORS (3U)
#define SENSOR_INTEGRATION_TIME_MS (10U)

#define MAX_DISTANCE_MM (4000.0F)
#define SENSOR_RESOLUTION (VL53L8CX_RESOLUTION_8X8)
#define SENSOR_RESOLUTION_X (8U)
#define SENSOR_RESOLUTION_Y (8U)

typedef enum {
    SENSOR_RIGHT = 0U,
    SENSOR_MIDDLE = 1U,
    SENSOR_LEFT = 2U,
} DistanceSensor;

using namespace robby;

void DistanceVisualizer::start()
{
    LOG_INFO(_log, "Sensor initialization...");

    int32_t status = 0;
    for (uint8_t i = 0; i < CONF_N_SENSORS; ++i) {
        _devices[i].platform.address = i;

        status |= vl53l8cx_init(&_devices[i]);
    }

    if (status) {
        LOG_WARN(_log, "vl53l8cx_init failed");
    }

    // start
    for (uint8_t i = 0; i < CONF_N_SENSORS; ++i) {
        bool failed = setup_sensor(&_devices[i]);
        if (failed) {
            LOG_WARN(_log, "Distance sensor %d setup failed", i);
            return;
        }
    }

    LOG_INFO(_log, "Ranging starts");
    for (uint8_t i = 0; i < CONF_N_SENSORS; ++i) {
        vl53l8cx_start_ranging(&_devices[i]);
    }
}

void DistanceVisualizer::process()
{
    for (uint8_t i = 0; i < CONF_N_SENSORS; ++i) {
        trigger_sensor(static_cast<DistanceSensor>(i));

        if (!_data_ready.tryAcquire(500U)) {
            LOG_WARN(_log, "Sensor conversion timed out");
        }
    }

    for (uint8_t i = 0; i < CONF_N_SENSORS; ++i) {
        vl53l8cx_get_ranging_data(&_devices[i], &_results[i]);
    }

    // Update resolut store
    _distance_map.lock.lock();
    for (size_t i = 0; i < CONF_N_SENSORS; ++i) {
        for (size_t x = 0; x < SENSOR_RESOLUTION_X; ++x) {
            for (size_t y = 0; y < SENSOR_RESOLUTION_Y; ++y) {
                size_t sensor_index = CONF_N_SENSORS - 1U - i;
                size_t cell = x + y * SENSOR_RESOLUTION_X;

                uint8_t status = _results[sensor_index].target_status[cell];
                int16_t distance = -1;
                if (status == 5U || status == 9U) {
                    distance = _results[sensor_index].distance_mm[cell];
                }
                // sent column by column: each run of 8 in the uplink is one zone column x
                _distance_map.sensors[i][x][y] = distance;
            }
        }
    }
    _distance_map.lock.unlock();
    _distance_map.updated.release();
    LOG_DEBUG(_log, "Room sensor view updated");
}

void DistanceVisualizer::conversion_done_callback()
{
    _data_ready.release();
}

bool DistanceVisualizer::setup_sensor(VL53L8CX_Configuration* device)
{
    int32_t status =
        vl53l8cx_set_ranging_frequency_hz(device, CONF_SENSOR_FREQUENCY_HZ);
    status |=
        vl53l8cx_set_ranging_mode(device, VL53L8CX_RANGING_MODE_AUTONOMOUS);
    status |= vl53l8cx_set_resolution(device, SENSOR_RESOLUTION);
    status |= vl53l8cx_set_integration_time_ms(device, SENSOR_INTEGRATION_TIME_MS);
    status |= vl53l8cx_set_external_sync_pin_enable(device, true);
    return status != 0;
}

void DistanceVisualizer::draw_results() const
{
    for (size_t sensor = 0; sensor < CONF_N_SENSORS; ++sensor) {
        uint16_t offset_x = static_cast<uint16_t>((CONF_N_SENSORS - sensor - 1U) * 84U);
        uint16_t offset_y = 80U;

        for (uint8_t y = 0; y < SENSOR_RESOLUTION_Y; ++y) {
            for (uint8_t x = 0; x < SENSOR_RESOLUTION_X; ++x) {
                size_t cell = x + y * SENSOR_RESOLUTION_X;

                uint8_t status = _results[sensor].target_status[cell];
                if (status != 5U && status != 9U) {
                    BSP_LCD_SetTextColor(LCD_COLOR_BLACK);
                } else {
                    int16_t distance = _results[sensor].distance_mm[cell];
                    uint16_t color =
                        util::map_color_rgb565(static_cast<float>(distance) / MAX_DISTANCE_MM);
                    BSP_LCD_SetTextColor(color);
                }

                BSP_LCD_FillRect(x * 9U + offset_x, y * 9U + offset_y, 9U, 9U);
            }
        }
    }
}

void DistanceVisualizer::trigger_sensor(DistanceSensor sensor)
{
    switch (sensor) {
    case DistanceSensor::RIGHT:
        HAL_GPIO_WritePin(TOF_SYNC1_GPIO_Port, TOF_SYNC1_Pin, GPIO_PIN_SET);
        HAL_GPIO_WritePin(TOF_SYNC1_GPIO_Port, TOF_SYNC1_Pin, GPIO_PIN_RESET);
        break;

    case DistanceSensor::MIDDLE:
        HAL_GPIO_WritePin(TOF_SYNC2_GPIO_Port, TOF_SYNC2_Pin, GPIO_PIN_SET);
        HAL_GPIO_WritePin(TOF_SYNC2_GPIO_Port, TOF_SYNC2_Pin, GPIO_PIN_RESET);
        break;

    case DistanceSensor::LEFT:
        HAL_GPIO_WritePin(TOF_SYNC3_GPIO_Port, TOF_SYNC3_Pin, GPIO_PIN_SET);
        HAL_GPIO_WritePin(TOF_SYNC3_GPIO_Port, TOF_SYNC3_Pin, GPIO_PIN_RESET);
        break;
    }
}
