stefanluethi/robby/app_core/src/service/tof_platform.c

/**
  *
  * Copyright (c) 2023 STMicroelectronics.
  * All rights reserved.
  *
  * This software is licensed under terms that can be found in the LICENSE file
  * in the root directory of this software component.
  * If no LICENSE file comes with this software, it is provided AS-IS.
  *
  ******************************************************************************
  */

#include "platform.h"
#include "main.h"

/* Macros defined for SPI communication */
#define VL53L8CX_COMMS_CHUNK_SIZE 4096
#define SPI_WRITE_MASK(x) (uint16_t)(x | 0x8000)  // 1
#define SPI_READ_MASK(x)  (uint16_t)(x & ~0x8000) // 0

extern SPI_HandleTypeDef hspi2;

static GPIO_TypeDef* sensor_chip_selec_port = NULL;
static uint16_t sensor_chip_selec_pin = 0;

static void select_sensor(uint8_t sensor_index)
{
	if (sensor_index == 0U) {
		sensor_chip_selec_port = TOF_CS1_GPIO_Port;
		sensor_chip_selec_pin = TOF_CS1_Pin;
	} else if (sensor_index == 1U) {
		sensor_chip_selec_port = TOF_CS2_GPIO_Port;
		sensor_chip_selec_pin = TOF_CS2_Pin;
	} else if (sensor_index == 2U) {
		sensor_chip_selec_port = TOF_CS3_GPIO_Port;
		sensor_chip_selec_pin = TOF_CS3_Pin;
	}
}


uint8_t VL53L8CX_RdByte(
		VL53L8CX_Platform *p_platform,
		uint16_t RegisterAdress,
		uint8_t *p_value)
{
	return VL53L8CX_RdMulti(p_platform, RegisterAdress, p_value, 1);
}

uint8_t VL53L8CX_WrByte(
		VL53L8CX_Platform *p_platform,
		uint16_t RegisterAdress,
		uint8_t value)
{
	return VL53L8CX_WrMulti(p_platform, RegisterAdress, &value, 1);
}

uint8_t VL53L8CX_WrMulti(
		VL53L8CX_Platform *p_platform,
		uint16_t RegisterAdress,
		uint8_t *p_values,
		uint32_t size)
{
	uint8_t status = 0;
	int32_t i = 0;
	uint32_t position = 0;
	uint32_t data_size = 0;
	uint16_t    temp;
	uint8_t data_write[VL53L8CX_COMMS_CHUNK_SIZE + 2];

	for (position = 0; position < size; position += VL53L8CX_COMMS_CHUNK_SIZE)
	{
		if (size > VL53L8CX_COMMS_CHUNK_SIZE)
		{
			if ((position + VL53L8CX_COMMS_CHUNK_SIZE) > size)
			{
				data_size = size - position;
			} else
			{
				data_size = VL53L8CX_COMMS_CHUNK_SIZE;
			}
		} else
		{
			data_size = size;
		}

		temp = RegisterAdress+position;

		data_write[0] = SPI_WRITE_MASK(temp) >> 8;
		data_write[1] = SPI_WRITE_MASK(temp) & 0xFF;

		for (i=0; i<data_size; i++)
		{
			data_write[i+2] = p_values[position + i];
		}


		data_size += 2;

		select_sensor(p_platform->address);
		HAL_GPIO_WritePin(sensor_chip_selec_port, sensor_chip_selec_pin, GPIO_PIN_RESET);
		status |= HAL_SPI_Transmit(&hspi2, data_write, data_size, 100*data_size);
		HAL_GPIO_WritePin(sensor_chip_selec_port, sensor_chip_selec_pin, GPIO_PIN_SET);
	}

	return status;
}

uint8_t VL53L8CX_RdMulti(
		VL53L8CX_Platform *p_platform,
		uint16_t RegisterAdress,
		uint8_t *p_values,
		uint32_t size)
{
	uint8_t status = 0;


	uint32_t position = 0;
	uint32_t data_size = 0;
	uint16_t    temp;
	uint8_t data_write[VL53L8CX_COMMS_CHUNK_SIZE + 2];

	for (position = 0; position < size; position += VL53L8CX_COMMS_CHUNK_SIZE)
	{
		if (size > VL53L8CX_COMMS_CHUNK_SIZE)
		{
			if ((position + VL53L8CX_COMMS_CHUNK_SIZE) > size)
			{
				data_size = size - position;
			} else
			{
				data_size = VL53L8CX_COMMS_CHUNK_SIZE;
			}
		} else
		{
			data_size = size;
		}

		temp = RegisterAdress+position;

		data_write[0] = SPI_READ_MASK(temp) >> 8;
		data_write[1] = SPI_READ_MASK(temp) & 0xFF;

		select_sensor(p_platform->address);
		HAL_GPIO_WritePin(sensor_chip_selec_port, sensor_chip_selec_pin, GPIO_PIN_RESET);
		status |= HAL_SPI_Transmit(&hspi2, data_write, 2, 0x1000);
		status |= HAL_SPI_Receive(&hspi2, p_values + position, data_size, 100*data_size);
		HAL_GPIO_WritePin(sensor_chip_selec_port, sensor_chip_selec_pin, GPIO_PIN_SET);
	}

	return status;
}

uint8_t VL53L8CX_Reset_Sensor(VL53L8CX_Platform *p_platform)
{
	return 0;
}

void VL53L8CX_SwapBuffer(
		uint8_t 		*buffer,
		uint16_t 	 	 size)
{
	uint32_t i, tmp;

	/* Example of possible implementation using <string.h> */
	for(i = 0; i < size; i = i + 4)
	{
		tmp = (
		  buffer[i]<<24)
		|(buffer[i+1]<<16)
		|(buffer[i+2]<<8)
		|(buffer[i+3]);

		memcpy(&(buffer[i]), &tmp, 4);
	}
}

uint8_t VL53L8CX_WaitMs(
		VL53L8CX_Platform *p_platform,
               uint32_t TimeMs)
{
	HAL_Delay(TimeMs);
	return 0;
}
