stefanluethi/robby/app_core/src/service/command_handler.h

#pragma once

#include "main.h"
#include "service/bench_load.h"
#include "service/drive.h"
#include "trace/link.h"

#include <array>
#include <cstdint>

#include <robby_link.pb.h>
#include <rtos/rtos.h>
#include <se-oss/log/Log.h>

namespace robby {

/// Carries out the actions blip invokes: the outpost sends them as Downlink frames with a
/// typed Invoke, each one is answered with an ActionResult of its id. The outpost owns the
/// list of actions and announces it to blip.
class CommandHandler
{
public:
    CommandHandler(se_oss::Logger log, Link& link, Drive& drive, BenchLoad& bench_load);
    /// Called by the UART interrupt with the received bytes
    void data_received_callback(void* data, std::size_t length);
    void process();

private:
    static constexpr std::size_t MAX_RX_CHUNK_LENGTH {256};
    struct RxChunk
    {
        std::size_t length {};
        std::array<uint8_t, MAX_RX_CHUNK_LENGTH> bytes {};
    };

    RxChunk _rx_chunk_irq {};
    RxChunk _rx_chunk_proc {};
    rtos::MessageQueue<RxChunk> _queue {10};

    robby_link_Record _record {};

    se_oss::Logger _log;
    Link& _link;
    Drive& _drive;
    BenchLoad& _bench_load;

    void handle(const robby_link_Downlink& downlink);
    /// Returns why the action was rejected, or nullptr
    const char* invoke(const robby_link_Invoke& invoke);
    /// mm/s, see MotorDrive
    const char* set_motor_drive(int32_t speed, int32_t turn);
    const char* set_bench_load(uint32_t rate, uint32_t batch);
};

}  // namespace robby
