stefanluethi/robby/app_core/src/proto/serializer.h

#pragma once

#include "service/distance_visualizer.h"
#include "service/imu.h"
#include "stream.h"
#include "thread_table.h"

namespace robby {

std::size_t serialize(uint8_t* buffer, std::size_t buffer_size, const int16_t* array, std::size_t length, uint8_t stream_id, uint32_t sequence_number);
std::size_t serialize(uint8_t* buffer, std::size_t buffer_size, const std::array<DistanceSensorImage, 3>& sensors);
std::size_t serialize(uint8_t* buffer, std::size_t buffer_size, const StreamDescriptor& descriptor);
std::size_t serialize(uint8_t* buffer, std::size_t buffer_size, const ThreadTable& thread_table);

}  // namespace robby
