stefanluethi/robby/(commit log)

2025-10-31 hardware: Add initial boards
    [BatteryPack.PrjPcb, Charger.SchDoc, Connectivity.SchDoc, DiscoCarrier.SchDoc, DistanceSensor.PcbDoc, DistanceSensor.PrjPcb, DistanceSensor.SchDoc, Misc.SchDoc]
2025-10-31 hardware: Route motor_base
    [Connectivity.SchDoc, DiscoCarrier.SchDoc, MotorBase.PrjPcb]
2025-10-31 hardware: Place battery pack components
    [BatteryPack.PrjPcb, Charger.SchDoc, DistanceSensor.PcbDoc, MonitoringProtection.SchDoc, MotorBase.PrjPcb, SensorAddOn.PcbDoc]
2025-11-02 hardware: Route battery pack
    [BatteryPack.PrjPcb, Charger.SchDoc, MonitoringProtection.SchDoc]
2025-11-02 hardware: Rename file
    [MotorBase.PrjPcb]
2025-11-02 hardware: add release docs and jobs
    [BatteryPack.PrjPcb, DistanceSensor.PrjPcb, MotorBase.PrjPcb, SensorAddOn.PrjPcb]
2025-11-07 hardware: review and clean up
    [BatteryPack.PrjPcb, Charger.SchDoc, Connectivity.SchDoc, DiscoCarrier.SchDoc, DistanceSensor.PcbDoc, DistanceSensor.PrjPcb, Misc.SchDoc, MonitoringProtection.SchDoc]
2025-11-08 hardware: create PCB panel
    [BatteryPack.PrjPcb, DistanceSensor.PcbDoc, DistanceSensor.PrjPcb, MotorBase.PrjPcb, RobbyPanel.PcbDoc, RobbyPanel.PrjPcb, SensorAddOn.PcbDoc, SensorAddOn.PrjPcb]
2026-01-09 feat: add cube base board config
2026-01-09 feat: add time of flight sensor example
2026-01-09 feat: replace time of flight sw package
    [app_tof.c, tof_platform.c]
2026-01-11 feat: Add STM32F723 bsp for LCD
2026-01-11 feat: use sync and int mode on TOF sensor
2026-01-11 feat: support 3 TOF sensors
2026-01-11 feat: set integration time on TOF sensor
2026-02-20 doc: add hardware pin map
2026-03-25 feat: add esp32 base application
2026-03-25 feat: add basic UART <-> websocket bridge
2026-04-01 feat: add imu readout
2026-04-01 feat: improve esp uart stability
    [main.rs]
2026-04-01 feat: add imu stream
2026-04-01 feat: improve heatmap theming
2026-05-05 feat: add message forwarding from websocket to uart
2026-05-05 feat: add uart reception into message queue using dma
2026-05-06 feat: improve c to c++ glue
2026-05-06 feat: add motor PWM configuration
2026-05-06 feat: add motor control cbor command
2026-05-14 refactor: rework c code to c++ class
    [app.cpp, data_publisher.cpp, data_publisher.h, distance_visualizer.cpp, distance_visualizer.h]
2026-05-15 feat: improve uart dma stability
    [main.c, robby.ioc]
2026-05-16 feat: add serialization thread
2026-05-20 feat: change command rx path to uart6
2026-05-22 fix: omit value when heatmap is too small
2026-05-23 fix: change fuel gauge registers
    [fuelgauge.c]
2026-05-23 feat: encode message in esp32
2026-10-12 fix: get embassy port of esp32 app working
    - only reconnect wifi after an actual disconnect instead of every 5s
    - pass all request headers to the websocket handshake parser
    - run uart in a higher priority interrupt executor and lower the rx fifo
    threshold to avoid fifo overflows at 1 Mbaud
    - start uart after radio init and resync on the next frame delimiter
    after rx errors
    - reduce per-frame logging to debug
    - read wifi ssid and password from WIFI_SSID / WIFI_PASSWORD at build time
2026-10-12 fix: recover imu acquisition when the fifo stops
    FIFO_CTRL4 of the LSM6DSO gets overwritten at runtime (read back as 0xa4
    instead of 0x06) shortly after the distance sensors start ranging. The
    FIFO then stays in bypass-to-continuous mode and no acceleration frames
    are produced anymore.
    - reconfigure the sensor from scratch when no sample arrived for 300ms
    and log the FIFO state
    - write FIFO_CTRL4 as a whole instead of read-modify-write
    - drain the whole FIFO every cycle instead of waiting for the watermark,
    reading tag and data in one transfer
    - stop batching the unused gyro samples to halve the i2c traffic
2026-10-17 feat: replace app_web with blip and trace with sonde
    Remove app_web; blip (github.com/stefanluethi/blip) takes its place.
    app_core traces with blip's sonde, fetched at a pinned commit:
    - acceleration as imu/acc/{x,y,z} in g, every 2nd sample
    - distance map as a 2D array, task stats as records, logs via se-oss
    - motor/speed as a blip action (hand-encoded, sonde has no actions yet)
    The ESP32 bridge forwards the sonde batches to blip over its websocket
    and no longer depends on the old proto crate.
2026-10-19 fix: stream the sonde traces without interruptions
    - app_core: pin blip at 96ff5b2, the pinned commit no longer exists
    - app_core: send on the link by interrupt instead of polling; the
    blocking transmit kept data_publisher busy 72% of the time and
    starved the distance acquisition (2 Hz instead of 6 Hz)
    - app_core: spread the IMU samples between the read times of
    consecutive frames, so the trace has no gap at each frame boundary
    (the IMU runs at ~806 Hz, not the nominal 833 Hz)
    - app_comm: keep the frames in static buffers instead of the heap;
    queued sonde batches of ~1 kB exhausted the heap and panicked the
    bridge, also give TCP a 16 KB send buffer for the ~65 kB/s stream
    - app_c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
2026-10-19 fix: turn off the gauge broadcast that stops the imu fifo
    A BQ28Z620 in BROADCAST mode writes its charging current to the charger
    address 0xD4 every 15 s. That's also the LSM6DSO's address, the write
    lands in FIFO_CTRL4 and stops the FIFO. Battery packs ship with it on.
    Before configuring the IMU, read I2C Configuration (DF 0x4602) over MAC
    and clear BCAST if it's set, verified by reading it back. Nothing is
    written when it's already clear or the gauge is SEALED. I2C2 runs at
    ~100 kHz for the access since the gauge doesn't answer at 400 kHz.
2026-10-19 feat: publish the battery state of the fuel gauge
    The IMU task reads the BQ28Z620 once per second: state of charge, pack
    and cell voltages and current, traced as battery/soc, battery/voltage,
    battery/cell1, battery/cell2 and battery/current with their units.
    The IMU task already owns I2C2, so it switches the bus to ~100 kHz for
    the gauge between two IMU transfers and back to 400 kHz, without a lock.
    The access takes a few ms, the IMU FIFO holds ~500 ms of samples. The
    values reach the data publisher through a queue of one.
2026-10-26 feat: add the bench tools to measure the trace link throughput
    tools/bench is a uv project with capture.py (records the blip WebSocket
    to a .blip recording and writes the metrics as .json), ramp.py (steps the
    bench/load action until drops start), report.py (markdown comparison and
    ramp knee) and decode.py (summary of a recording). A simulated bridge in
    sonde and outpost style backs the pytest suite and can be run by hand.
    The bench-robby skill holds the runbook of the hardware campaign.
2026-10-26 feat: add the protobuf schema of the stm32-esp32 link
    robby_link.proto defines the Uplink records (IMU batches, distance
    images, battery, tasks, logs, action results, link stats, synthetic
    load) and the Downlink with typed Invoke args for motor/speed and
    bench/load. The nanopb options and micropb config keep every field
    static, the README documents the framing (CRC-16 + COBS, 1 KiB), seq
    gaps, the blip paths the outpost emits and the actions it announces.
    Golden vectors for the encoder and outpost tests come with their
    generator.
2026-10-26 feat: trace over the protobuf link with nanopb
    Replace sonde (blip CBOR on the STM32) with compact nanopb frames for the
    ESP32 outpost, following proto/README.md:
    - nanopb 0.4.9.1 via FetchContent, robby_link.pb.c generated at build time
    from ../proto (cmake/robby_link.cmake, shared with the host tests)
    - UplinkWriter packs records into frames: seq, records up to 1022 bytes or
    32 records, sizes checked with pb_get_encoded_size, CRC-16/CCITT-FALSE
    (STM32 CRC unit, table as fallback), COBS; double buffered
    - USART2 TX by DMA (DMA1 stream 6), set up in code, not in robby.ioc
    - DownlinkReader: COBS, CRC, Downlink decoding, seq gap counting
    - LinkStats once per second: tx bytes/frames/writ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
2026-10-26 test: host tests of the protobuf link against the golden vectors
    New app_core/test CMake project (host gcc, Catch2 v3.8.1, nlohmann/json)
    building the portable trace path with -fno-exceptions -fno-rtti:
    - every vector's .bin framed to its .frame byte for byte
    - uplink vectors decoded record by record and compared with their JSON,
    then re-encoded by UplinkWriter to the same .frame
    - the record builders (IMU batching, distance layout, battery, tasks,
    log, action result) produce the vectors' frames from app_core data
    - packing (1022 bytes, 32 records), seq wrap, transport drops
    - downlink vectors decoded and compared with their JSON; CRC, COBS,
    protobuf and size errors; seq gaps and rest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
2026-10-26 feat: translate the protobuf link to blip on the esp32
    The ESP32 becomes the robby outpost: it decodes the Uplink frames of the
    STM32 (protobuf, CRC-16, COBS, see proto/README.md) and sends standard blip
    CBOR on the WebSocket; blip's Invoke requests become Downlink frames.
    - new no_std crate outpost-core, tested on the host: streaming COBS + CRC
    deframing, seq gaps, record-by-record micropb decoding, the README mapping
    to blip messages with minicbor (shortest floats, imu/acc as {x,y,z}),
    batching into CBOR-sequence frames of up to 4 KiB with a flush deadline,
    ValueMetadata + Actions for each client, Invoke -> Downlink with checks
    and a 1 s timeout, outpost/* counters, the bench-wi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
2026-10-26 fix: measure the bench load backlog from the last sample of a batch
    A batch is only due once its last sample is, batch_ns - period_ns after
    its first. The backlog was measured from the first sample, so with
    batches spanning ~100 ms (rate 1000, batch 100) almost every batch was
    already "late" when the 10 ms publisher emitted it: 87 % were dropped on
    hardware at 8 % UART load. The skip now drops only the batches whose last
    sample is more than MAX_BACKLOG_NS late (ceil, not floor + 1).
2026-10-26 docs: add the protobuf tracing plan and its benchmark report
    The plan describes the protobuf link between the STM32 and the ESP32
    outpost, the agent workstreams and the hardware campaign. The report
    measures it on robby: all 806 IMU samples/s at 8 % UART load (sonde:
    403/s at 69 %, 521 of 806/s once the link is full). The ESP32 CPU now
    limits the chain at about 7k samples/s, before the UART (about 11k/s).
2026-10-27 fix: store the distance map row by row so the UI shows it upright
    The map was stored as sensors[s][x][y], but the uplink sends each run of 8
    as a row, so the UI showed every sensor image transposed. Store it as
    sensors[s][y][x] and update the layout notes in the proto, README and tests.
2026-10-29 feat: forward raw protobuf from the ESP32 and translate it on the PC
    The ESP32 decoded the Uplink records and built blip CBOR itself, so every
    change of robby_link.proto needed new bridge firmware. Now:
    - app_comm is a plain bridge (crate outpost-core -> bridge-core, binary
    robby-bridge): it checks COBS and the CRC and sends each Uplink payload
    as a binary WebSocket frame, frames the outpost's Downlink payloads for
    the STM32, and sends its own counters as JSON text frames (bridge/*).
    micropb, minicbor, the translation and bench-wifi are gone. Downlink
    frames are capped at 128 bytes: the UART task runs in an interrupt
    executor on the interrupted task's stack, and 1 KiB frames ove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
2026-10-29 fix: send the distance map column by column
    Each run of 8 in the uplink is now one zone column x of a sensor
    (sensors[s][x][y]), which flips rows and columns of the image in blip. With
    it, objects spanning two sensors line up across the stacked images. Update
    the layout notes in the proto, README and tests.
2026-10-29 fix: read the battery current from Current() at 0x0C
    The gauge read 0x0A, which on the BQ28Z620 is BatteryStatus(), so
    battery/current showed the status flags and barely changed. Current() is at
    0x0C (SLUUCO9B 14.1.7). Checked on the robot: about -5 mA idle, down to
    -71 mA with both motors running.
2026-10-29 feat: drive both motors in both directions with motor/speed
    MotorSpeed now has a signed per mille speed for each motor (m1, m2,
    -1000..1000); the old unsigned speed field is reserved. The DRV8874 runs in
    PH/EN mode: the TIM9 PWM sets the duty cycle and MOT_EN_x, which is the
    DIR pin, the direction. Motor 2 is mounted the other way round, so the
    STM32 reverses it and positive speeds on both drive the robot forward.
    TIM9 channel 2 is now started too.
    Update the golden vectors, the C++ and outpost tests and the README.
2026-10-29 fix: show the three distance sensors side by side
    The sensors are mounted next to each other, but blip stacked their images
    vertically (24 rows of 8), and the previous fix transposed each sensor
    instead. Store each sensor upright again (sensors[s][y][x]) and send zone
    row y of all three sensors as one row of 24: index (y * 3 + s) * 8 + x,
    shape [8, 24]. Update the proto, README and tests.
2026-10-29 fix: reverse the direction of both motors
    With positive speeds on m1 and m2 the robot drove backwards. Reverse motor 1
    instead of motor 2, so positive speeds drive it forward.
2026-10-29 feat: drive with speed and turn, held by the wheel encoders
    The motor/drive action (MotorDrive) replaces motor/speed: speed and turn in
    mm/s, -400..400. The left wheel runs at speed - turn, the right one at
    speed + turn, so a positive turn turns left; at more than 400 mm/s on a wheel
    the speed is reduced and the turn kept. Invoke.motor_speed and MotorSpeed are
    gone, member 2 is reserved.
    A new drive task holds the speed of each wheel every 20 ms with a PI loop
    plus feedforward on its encoder (TIM2, TIM3, now counting both edges of both
    channels). Both 0 puts the DRV8874 to sleep, so the wheels coast. The loop
    math is in drive_control, without the HAL, with host tests.
    The Drive record (mot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
2026-10-29 feat: stream the position of the robot from the wheel encoders
    A new odometry (drive::Odometry, without the HAL, with host tests) moves the
    pose by the encoder counts of each wheel, every 20 ms in the drive task, also
    while the wheels coast. It follows the arc of each period, so it is exact for
    a constant wheel speed. The pose starts at 0 at the reset: x forward, y to
    the left, heading counterclockwise.
    The Pose record (member 9, pose/* in blip, 50 Hz) has x and y in mm and the
    heading in hundredths of a degree, about 1 kB/s on the UART.
    Still to check on the robot: the track width (120 mm assumed), by turning on
    the spot 10 times.
    Add the uplink_pose vector, the C++, bridge and outpost t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
2026-10-29 fix: use the measured 145 mm between the wheel centers
    The odometry assumed 120 mm.
2026-10-29 fix: correct the encoder signs and the wheel sides, stop runaway wheels
    With 1 mm/s both motors went to full duty: the encoders count up while their
    motor runs with DIR low, not high, so the speed loop saw each wheel turning
    the wrong way and drove it ever faster. Each wheel now has its own encoder
    sign. The odometry uses the same counts, so the pose was wrong too.
    Motor 2 drives the left wheel and motor 1 the right one, the other way round
    the turn and the pose heading were inverted.
    A RunawayCheck stops both motors, until the next motor/drive, when a wheel
    turns against its duty for 100 ms or stands still at full duty for 1 s. The
    drive task logs why in its own log context, drive (COMPON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
2026-10-29 feat: stream the position of the robot from the IMU alone
    A new ImuOdometry (without the HAL, with host tests) tracks the pose from the
    LSM6DSO only, independent of the wheel encoders:
    - Heading: the gyro rate about the up axis, integrated. Up is the gravity
    vector measured at rest, so the tilted mounting (about 11 degrees) doesn't
    matter.
    - Position: the acceleration along the forward axis (IMU +y, found by pushing
    the robot) in the floor plane, integrated to a speed along the heading. The
    robot can't move sideways, so the sideways part is left out.
    - Rest: little vibration, the acceleration as strong as gravity and no
    rotation for 0.3 s set the speed to 0 and learn the gyro bias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
