stefanluethi/robby/(notices)

Notices in the files:
app_core/Core/Inc/main.h:
Copyright (c) 2025 STMicroelectronics.
All rights reserved.
